Evilinator/BuckConverterTest/BuckTest1.xls

ref | value | footprint | MFG Part Number | Digikey Orderable | Notes
C1 | DNP | 603 | ~ | ~ | DNP
C2 | 100uF | D3L | 20TQC100MYF | P16503TR-ND
C3 | 1uF | 603 | GRM188F51E105ZA12D | 490-3895-1-ND
C4 | 0.1uF | 603 | GRM188F51E104ZA01D | 490-1575-1-ND
C5 | 1uF | 603 | GRM188F51E105ZA12D | 490-3895-1-ND
C6 | 10nF | 603 | GRM188R71E103KA01D | 490-1520-1-ND
C7 | 33nF | 603 | GRM188R71E333KA01D | 490-1521-1-ND
C8 | DNP | 603 | ~ | ~ | DNP
C9 | 0.1uF | 603 | GRM188F51E104ZA01D | 490-1575-1-ND
C10 | 1uF | 603 | GRM188R60J105KA01D | 490-1550-1-ND
C11 | 10uF | 603 | GRM188R60J106ME47D | 490-3896-1-ND
C12 | 330uF | D4 | 6TPE330MAA | P16626CT-ND
J1 | POWERCONN | 8x1 Pin Array | 68002-408HLF | 609-3406-ND
J2 | POWERCONN | 8x1 Pin Array | 68002-408HLF | 609-3406-ND
L1 | 22uH | SRR1280 | SRR1280-220M | SRR1280-220MCT-ND
R1 | 56k | 603 | ERJ-3EKF5602V | P56.0KHCT-ND
R2 | 10k | 603 | ERJ-3EKF1002V | P10.0KHCT-ND
R3 | 51k | 603 | ERJ-3EKF5102V | P51.0KHCT-ND
R4 | 0 | 603 | ERJ-3GEY0R00V | P0.0GCT-ND
R5 | 9.1k | 603 | ERJ-3EKF9101V | P9.10KHCT-ND
R6 | 3.9k | 603 | ERJ-3EKF3902V | P3.90KHCT-ND
U1 | LM3102 | HTSSOP | LM3102MHX/NOPB | 296-35274-2-ND
