Evilinator/BuckConverterTest/(list of files, drawings)

Other design files:
BuckTest1.dsn
