Evilinator/BuckConverterTest/BuckTest1.kicad_pcb

## KiCad design BuckTest1.kicad_pcb (2013-09-16)

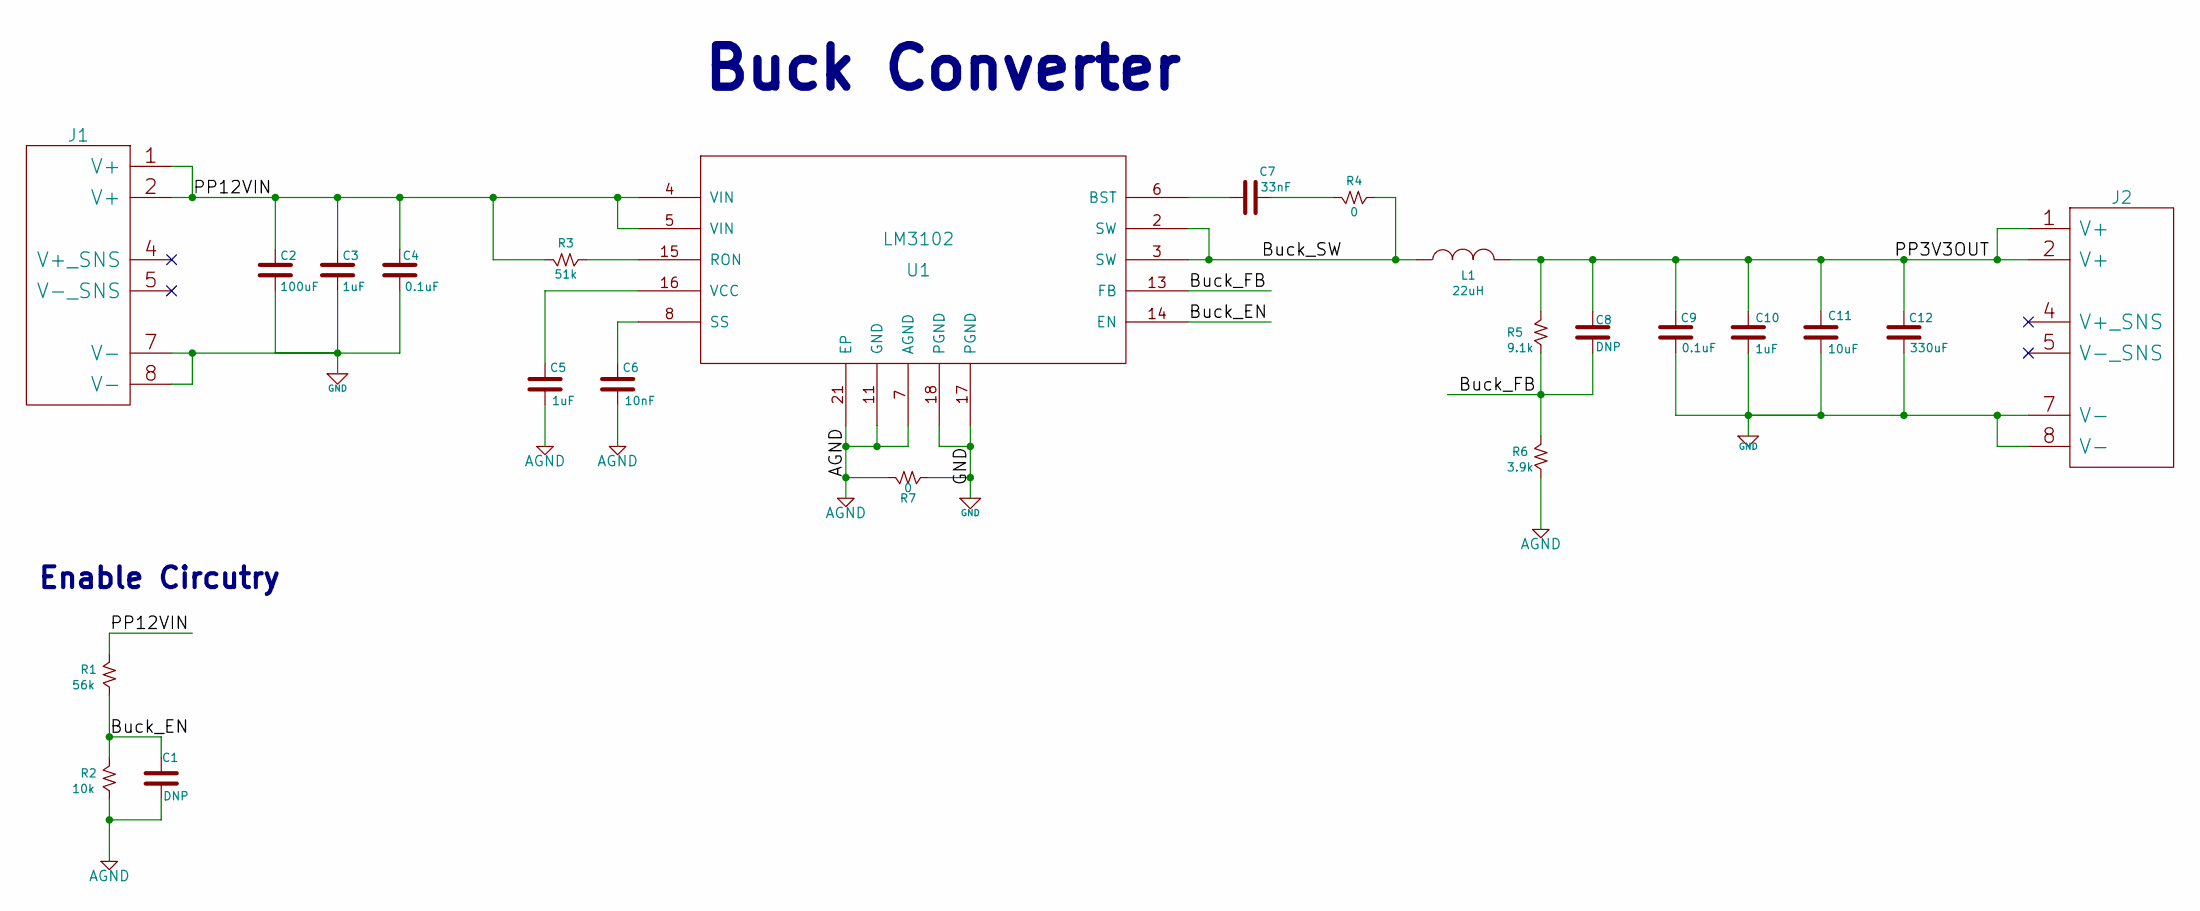
[picture p1: schematic BuckTest1.sch, 12V to 3.3V 2A Buck Converter 500kHz]

Parts:
C1, C8: DNP; 0603
C2: 100uF; D3L
C3: 1uF; 0603; Voltage 25V
C4: 0.1uF; 0603; Voltage 25V
C5, C10: 1uF; 0603
C6: 10nF; 0603
C7: 33nF; 0603
C9: 0.1uF; 0603
C11: 10uF; 0603
C12: 330uF; D4
J1, J2: POWERCONN; 8x1 Pin Array
L1: 22uH; SRR1280
R1: 56k; 0603
R2: 10k; 0603
R3: 51k; 0603
R4: 0; 0603
R5: 9.1k; 0603
R6: 3.9k; 0603
R7: 0
U1: LM3102; HTSSOP

Connections:
/Buck_EN: C1.1, R1.2, R2.1, U1.14 (EN)
/Buck_FB: C8.2, R5.2, R6.1, U1.13 (FB)
/Buck_SW: L1.1, R4.2, U1.2 (SW), U1.3 (SW)
/PP3V3OUT: C8.1, C9.1, C10.1, C11.1, C12.1, J2.1 (V+), J2.2 (V+), L1.2, R5.1
/PP12VIN: C2.1, C3.1, C4.1, J1.1 (V+), J1.2 (V+), R1.1, R3.1, U1.4 (VIN), U1.5 (VIN)
AGND: C1.2, C5.2, C6.2, R2.2, R6.2, R7.1, U1.7 (AGND), U1.11 (GND), U1.21 (EP)
GND: C2.2, C3.2, C4.2, C9.2, C10.2, C11.2, C12.2, J1.7 (V-), J1.8 (V-), J2.7 (V-), J2.8 (V-), R7.2, U1.17 (PGND), U1.18 (PGND)
unnamed: C7.2, R4.1
unnamed: C5.1, U1.16 (VCC)
unnamed: C6.1, U1.8 (SS)
unnamed: C7.1, U1.6 (BST)
unnamed: R3.2, U1.15 (RON)

Notes on the sheet:
Buck Converter
Enable Circutry

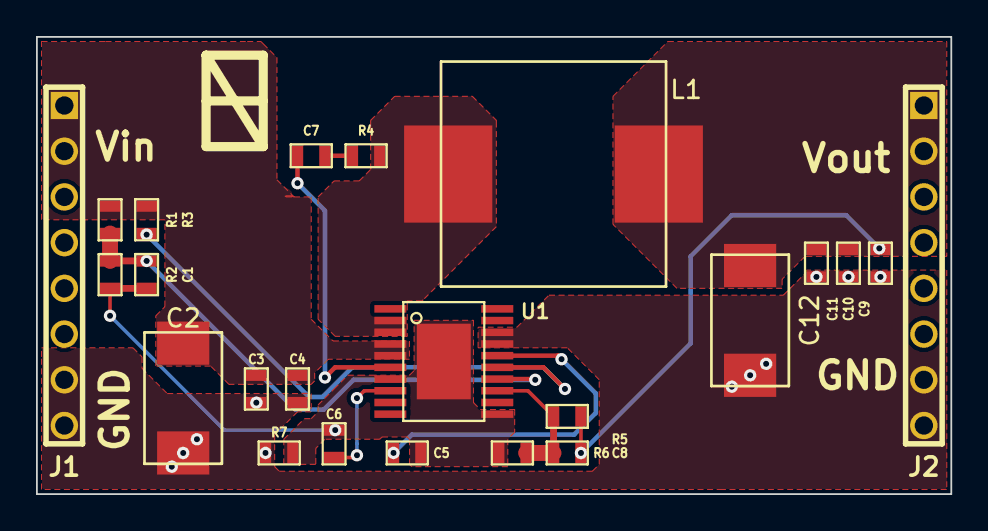
[picture p2: board BuckTest1.kicad_pcb from above]

Board: 2 copper layers, 50.8 x 25.4 mm, 23 parts (0 on the bottom side), 12 nets.
