Evilinator/BuckConverterTest/(commit log)

2013-08-20 Create Repository
    First Creation of the Repository
    [BuckTest1.sch]
2013-08-21 Create BOM + Update Component Values
    Need to select new inductor due to non-stock at digikey
    BOM created
    Sch Values Updated
    [BuckTest1.sch, BuckTest1.xls]
2013-08-21 Finalized Component / Footprint Selection
    Schematic and preliminary BOM complete. Layout is next step.
    [BuckTest1.sch, BuckTest1.xls]
2013-08-23 Created PCB
    Altered schematic to connect GND planes.
    Created layout, single layer implementation not possible
    [BuckTest1.kicad_pcb, BuckTest1.sch]
2013-08-27 Copper layout complete
    Hand routed first board to test KiCad layout features. .dsn an .ses are
    autoroute files. Initial copper layout complete, could use improvements
    but will function.
    [BuckTest1.dsn, BuckTest1.kicad_pcb]
2013-09-16 BuckConverterTest V0
    Silkscreen complete
    Sent for fab to OSH Park
    [BuckTest1.kicad_pcb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]
